2ni/lora-e5-breakout-board/hardware/PCB_PCB_2020-11-25_10-07-15_2020-12-09_15-23-49.pdf

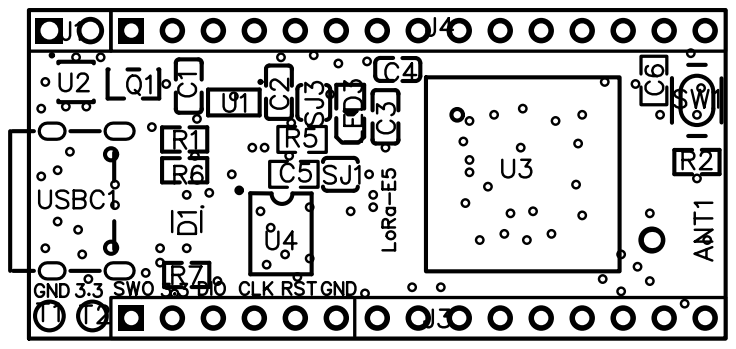
[picture p3: page 1]
