2ni/lora-e5-breakout-board/hardware/Schematic_LoRa-E5 breakout board_2020-12-21_17-14-32.png

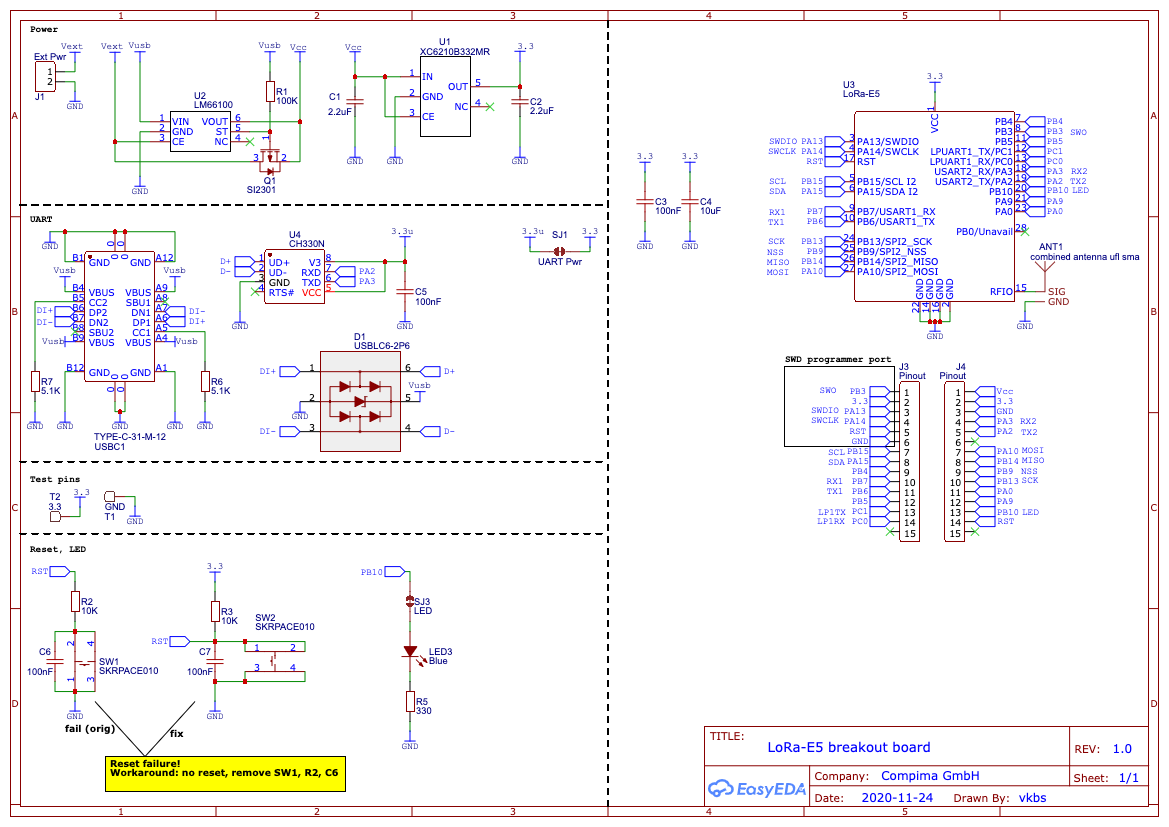
hardware/Schematic_LoRa-E5 breakout board_2020-12-21_17-14-32.png
