2ni/lora-e5-breakout-board/hardware/Schematic_LoRa-E5 breakout board_2020-12-21_17-12-51.pdf

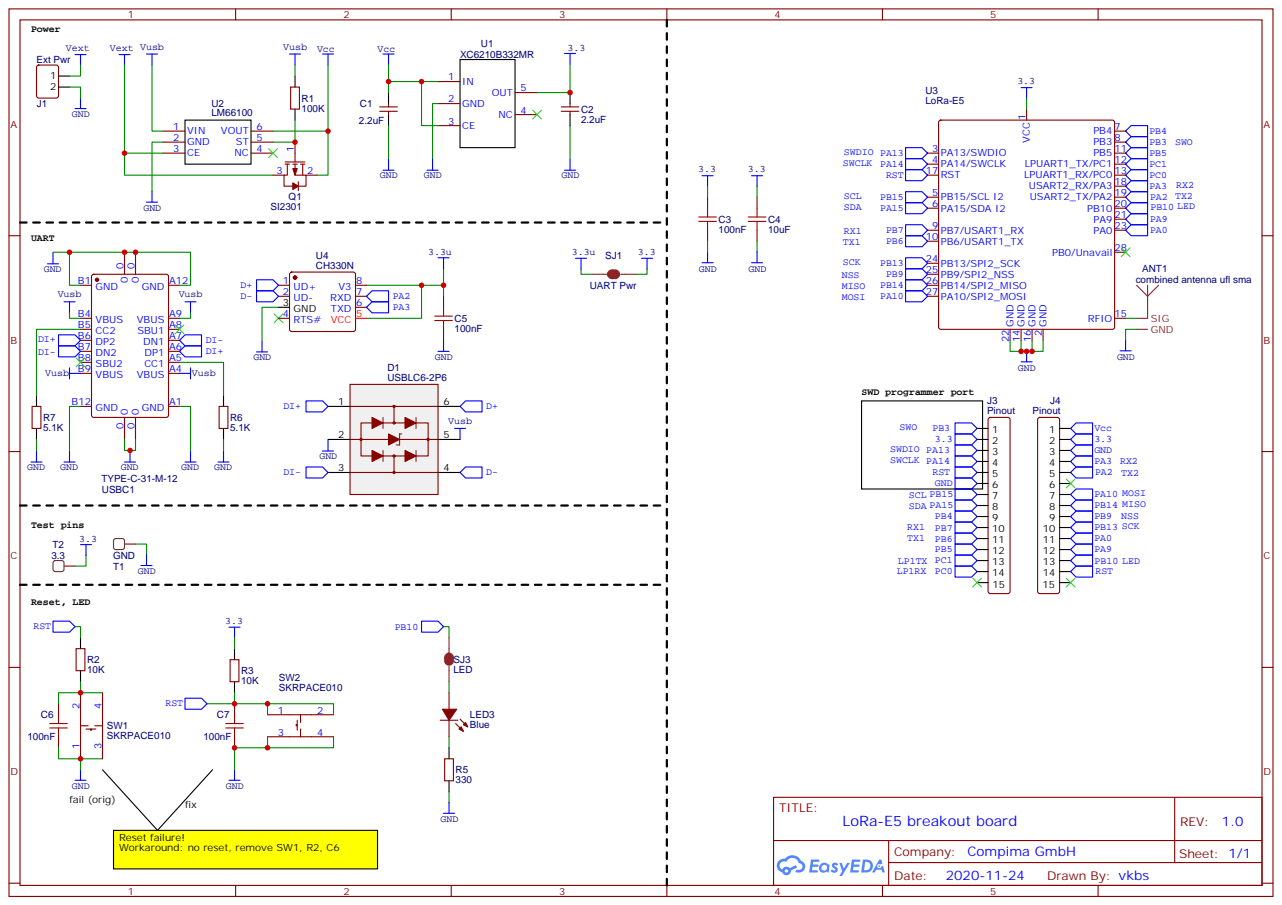
[picture p5: page 1]

combined antenna ufl sma

Reset failure!
Workaround: no reset, remove SW1, R2, C6
