2ni/lora-e5-breakout-board/hardware/BOM-LoRa-E5.pdf

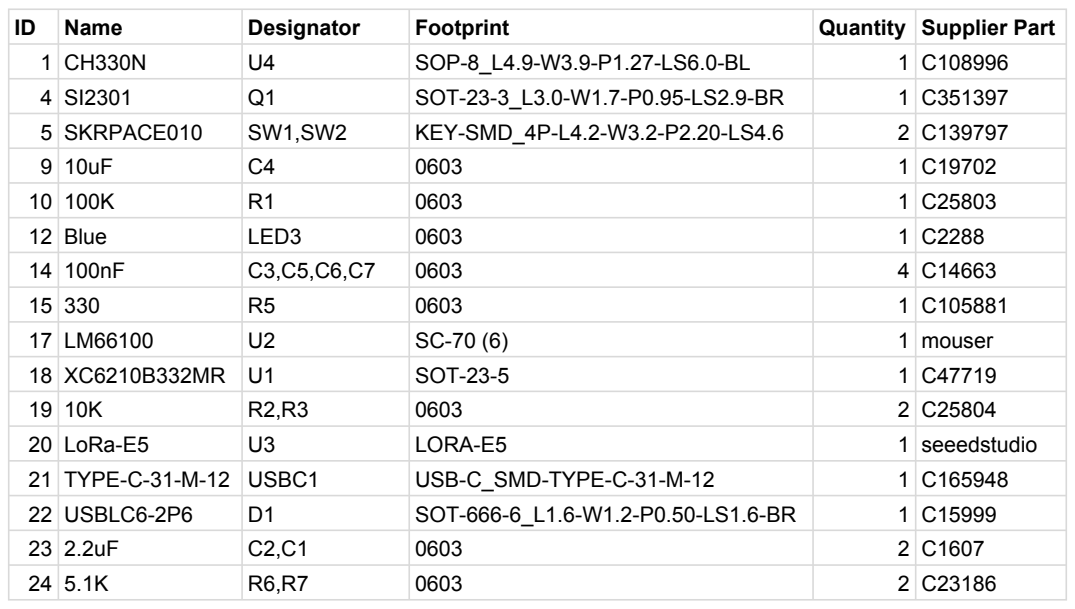
[picture p6: page 1]
