2ni/lora-e5-breakout-board/hardware/PCB_PCB_2020-11-18_13-14-42_2020-12-09_15-25-33.pdf

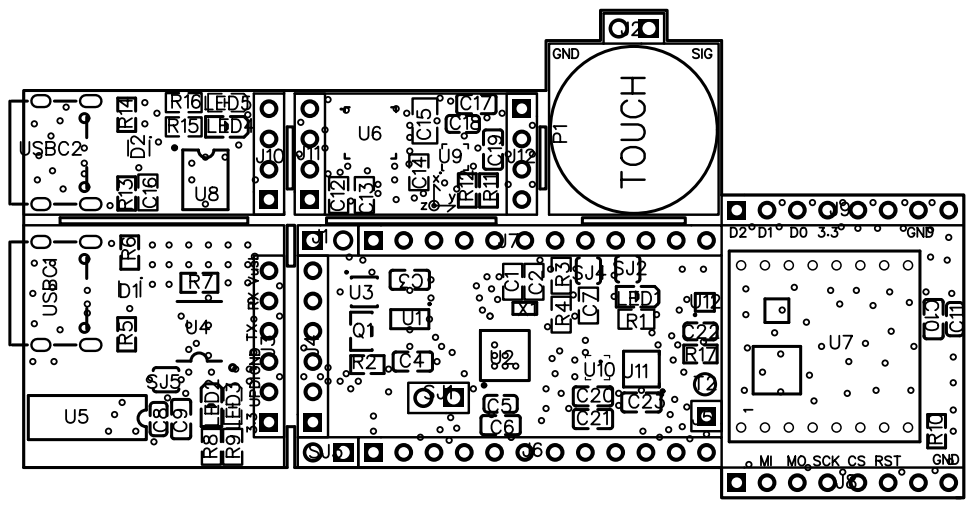
[picture p7: page 1]
