2ni/lora-e5-breakout-board/hardware/PCB_PCB_2020-11-25_10-07-15_2020-12-21_17-13-21.pdf

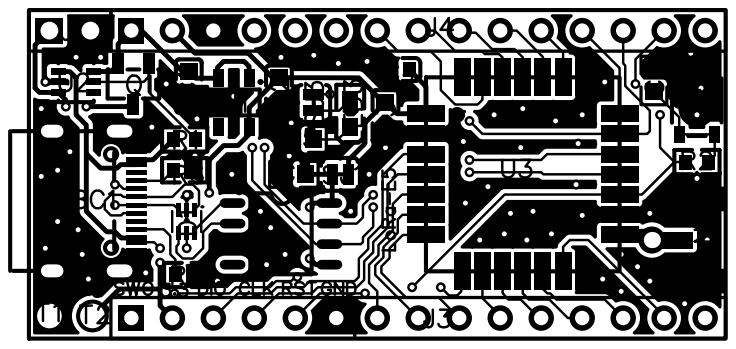
[picture p8: page 1]
