2ni/lora-e5-breakout-board/software/cubeide/blink/blink.ioc

Mcu.UserName=STM32WLE5JBIx
PB10.GPIO_Label=LED1
PB10.Signal=GPIO_Output
