2ni/lora-e5-breakout-board/(commit log)

2020-12-24 added bom (not 100% correct though)
2020-12-24 remove not working stm example
    [blink.ioc]
2020-12-24 added blink example from cubeide (might not work, if just opening the project due to strange cubeIDE settings)
    [blink.ioc]
